DreClark-EET/prosthetic-arm-series/AssembledPrototypeV1.jpeg

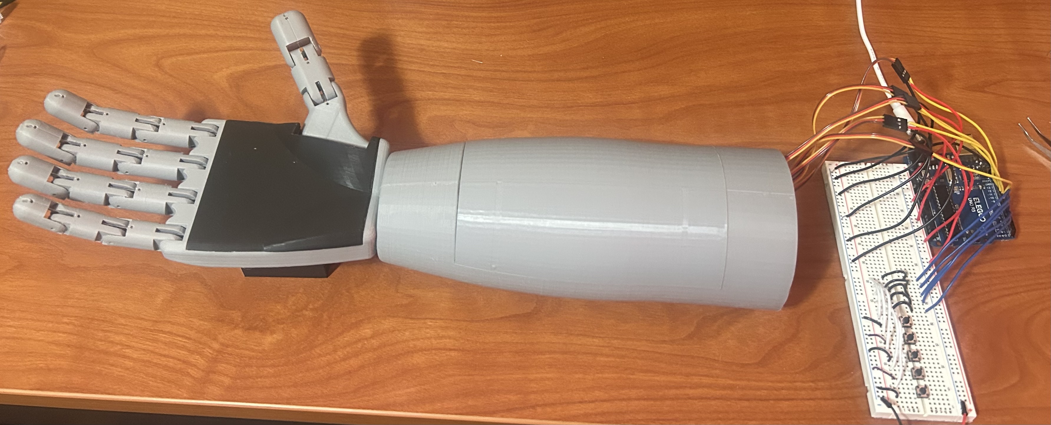
AssembledPrototypeV1.jpeg
