DreClark-EET/prosthetic-arm-series/BreadboardCircuit.jpeg

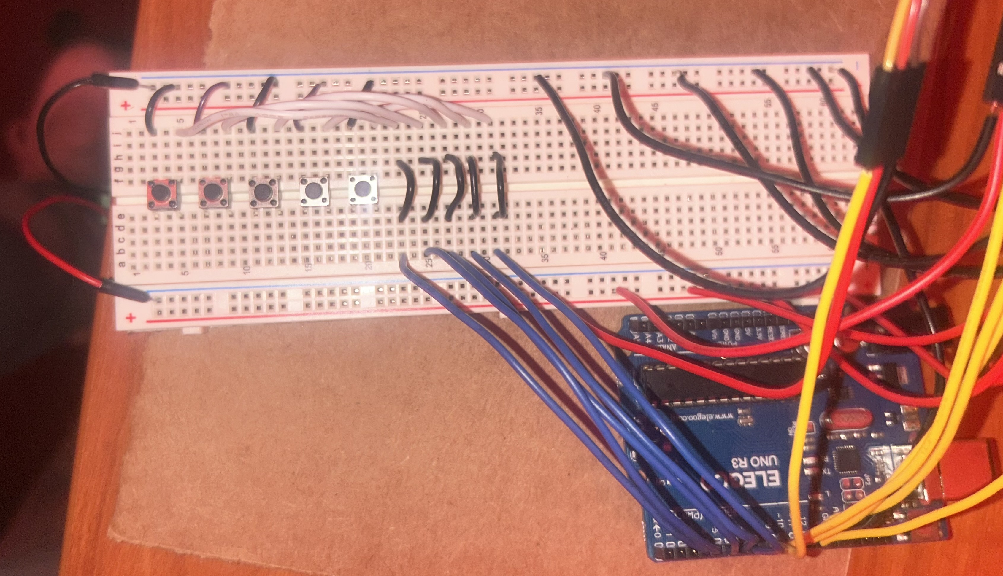
BreadboardCircuit.jpeg
