DreClark-EET/prosthetic-arm-series/(list of files, drawings)

Other design files:
DragRaceTiming.ms14
